chirayujain/SolarPoweredAQM/CAD/STLs/Battery Cover.stl

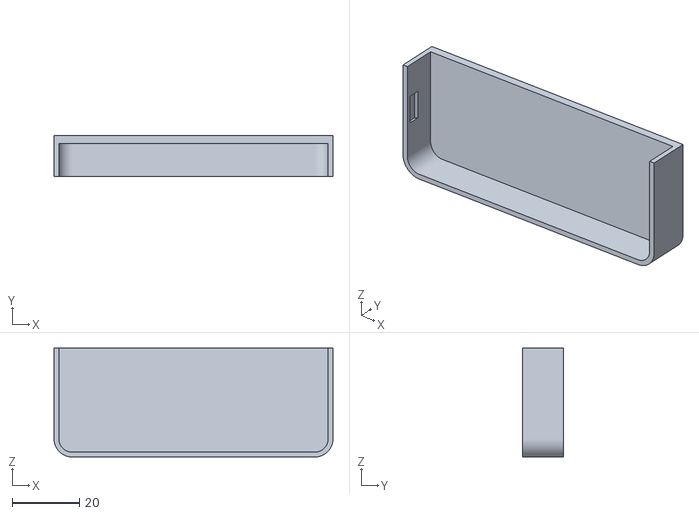
[picture p1: CAD file, 2025-01-18]
CAD/STLs/Battery Cover.stl
83.2 x 12.2 x 32.5
