chirayujain/SolarPoweredAQM/CAD/STLs/Enclosure Back.stl

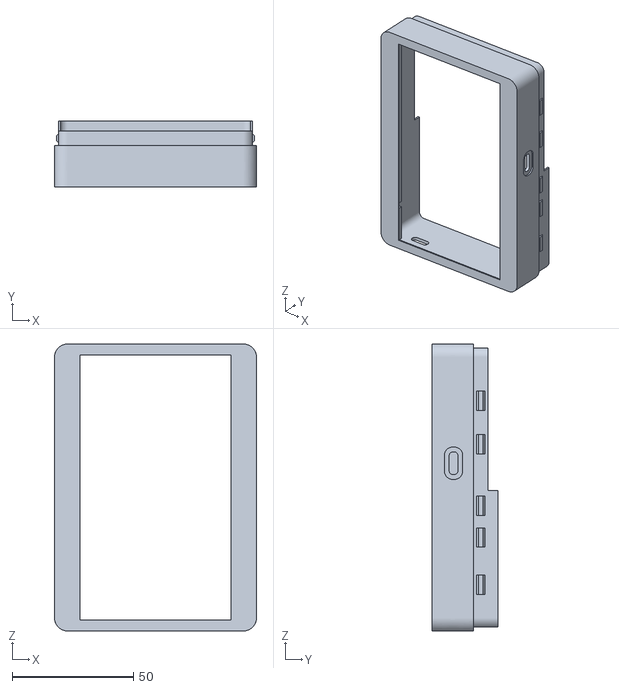
[picture p2: CAD file, 2025-01-18]
CAD/STLs/Enclosure Back.stl
83.2 x 27.0 x 118.2
