chirayujain/SolarPoweredAQM/CAD/STLs/Display Cover.stl

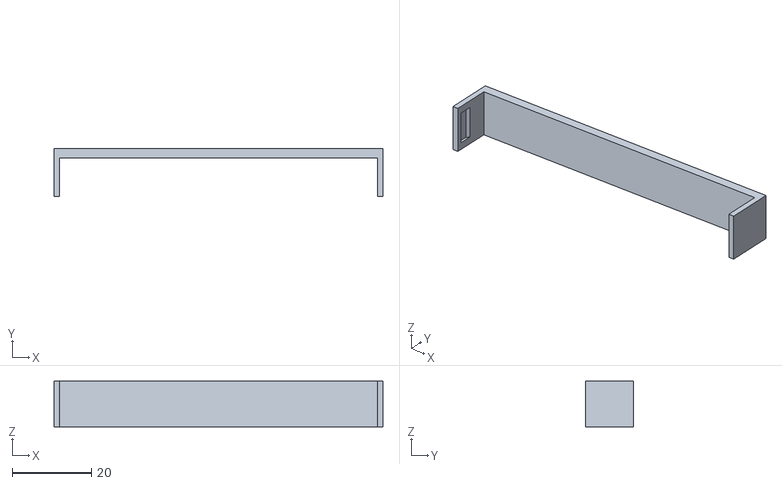
[picture p3: CAD file, 2025-01-18]
CAD/STLs/Display Cover.stl
83.2 x 12.2 x 11.6
