chirayujain/SolarPoweredAQM/CAD/STLs/Logo Panel.stl

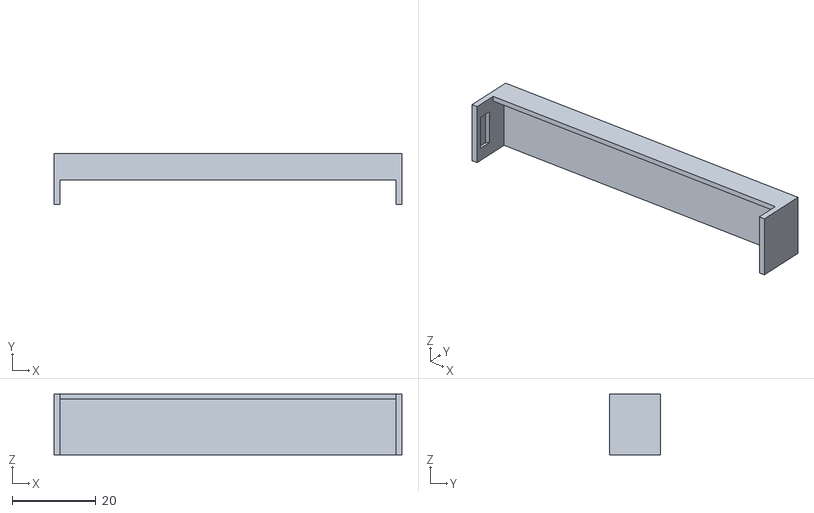
[picture p4: CAD file, 2025-01-18]
CAD/STLs/Logo Panel.stl
83.2 x 12.2 x 14.5
