chirayujain/SolarPoweredAQM/CAD/STLs/Vent.stl

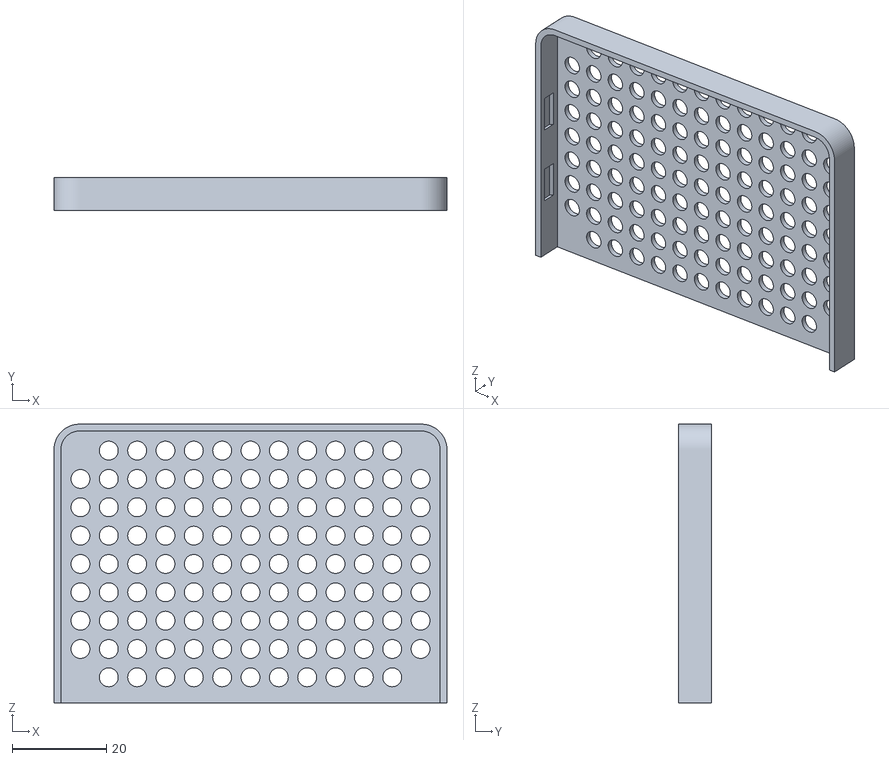
[picture p5: CAD file, 2025-01-18]
CAD/STLs/Vent.stl
83.2 x 7.05 x 59.0
