chirayujain/SolarPoweredAQM/CAD/STLs/LEDChannel.stl

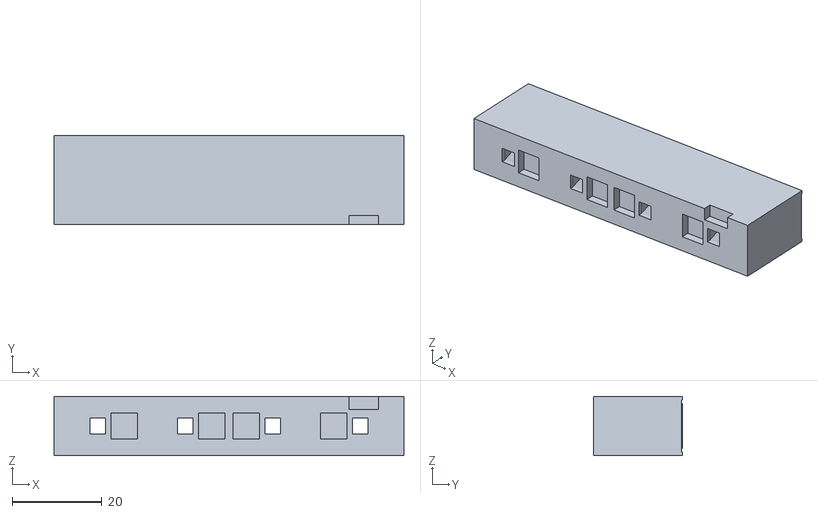
[picture p6: CAD file, 2025-01-18]
CAD/STLs/LEDChannel.stl
78.0 x 19.8 x 13.2
