chirayujain/SolarPoweredAQM/CAD/STLs/PMS Clip.stl

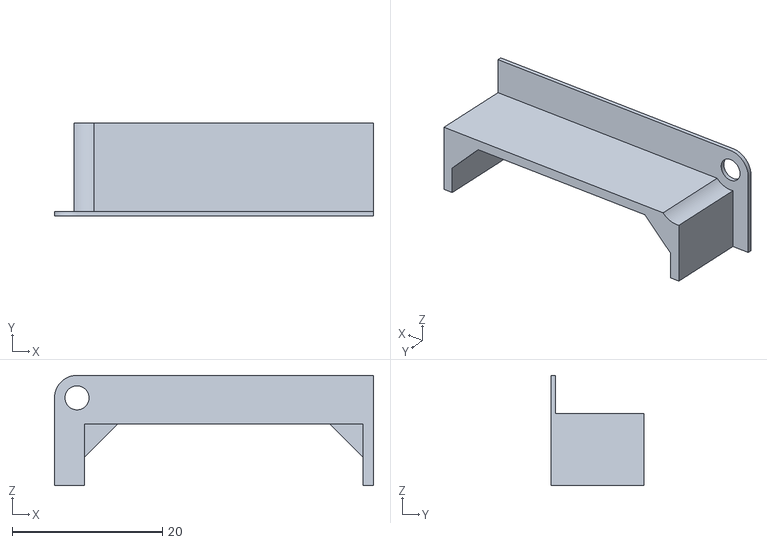
[picture p7: CAD file, 2025-01-18]
CAD/STLs/PMS Clip.stl
42.5 x 12.3 x 14.7
