chirayujain/SolarPoweredAQM/CAD/STLs/Wirechannel.stl

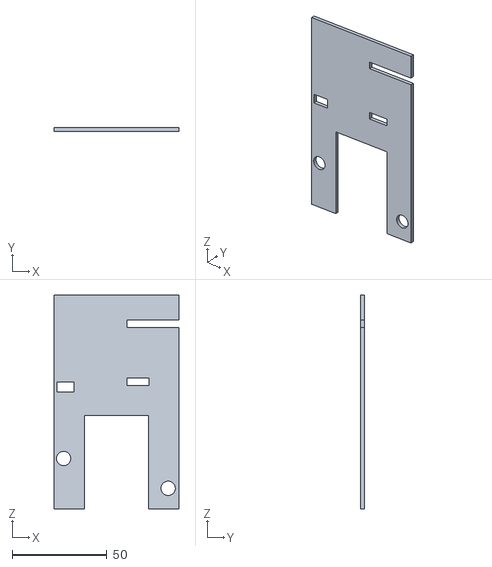
[picture p8: CAD file, 2025-01-18]
CAD/STLs/Wirechannel.stl
66.0 x 2.00 x 113.0
