chirayujain/SolarPoweredAQM/Electronics/Mainboard/AirQualityMonitorV1.kicad_pcb

## KiCad design Electronics/Mainboard/AirQualityMonitorV1.kicad_pcb (2025-01-18)

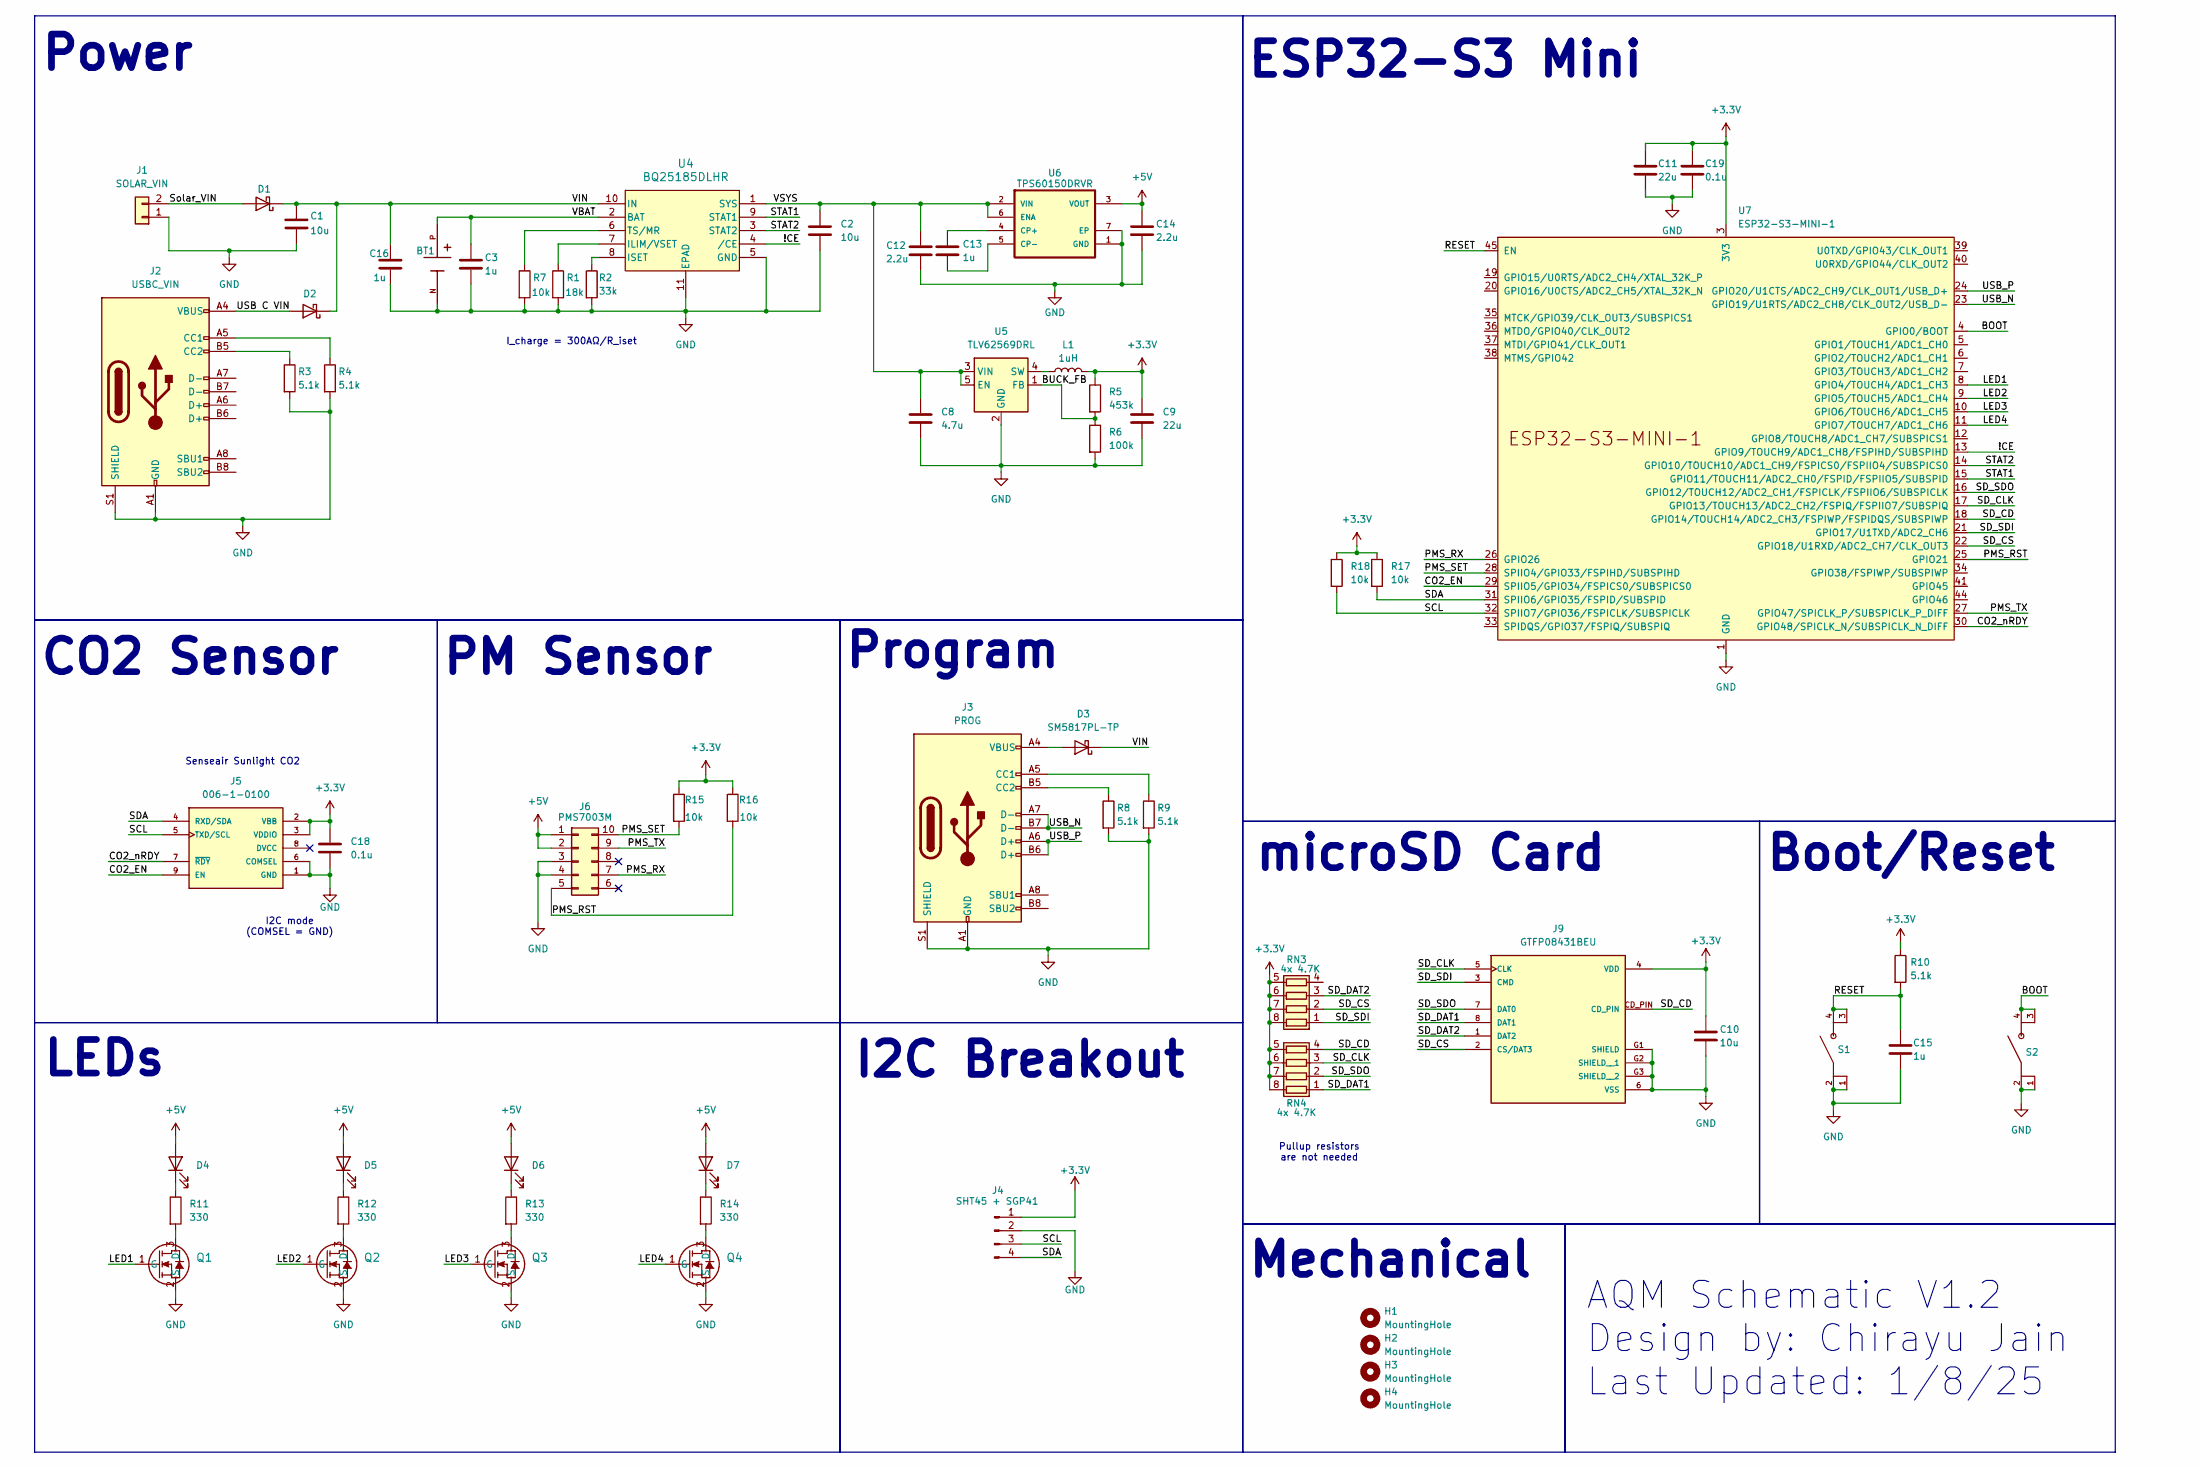
[picture p9: schematic AirQualityMonitorV1.kicad_sch]

Parts:
BT1: 1043; 1043_BAT_1043; PARTREV J
C1, C2, C10: 10u; C_0603_1608Metric
C3, C13, C15, C16: 1u; C_0603_1608Metric
C8: 4.7u; C_0603_1608Metric
C9, C11: 22u; C_0603_1608Metric
C12, C14: 2.2u; C_0603_1608Metric
C18, C19: 0.1u; C_0603_1608Metric
D1, D2, D3: SM5817PL-TP; D_SOD-123F
D4, D5, D6, D7: LED; LED_Luminus_MP-3030-1100_3.0x3.0mm
H1, H2, H3, H4: MountingHole; MountingHole_3.2mm_M3
J1: SOLAR_VIN; PinHeader_1x02_P2.54mm_Vertical
J2: USBC_VIN; USB_C_Receptacle_GCT_USB4105-xx-A_16P_TopMnt_Horizontal
J3: PROG; USB_C_Receptacle_GCT_USB4105-xx-A_16P_TopMnt_Horizontal
J4: SHT45 + SGP41; PinHeader_1x04_P2.54mm_Vertical
J5: 006-1-0100; 006-0-0002_XDCR_006-0-0002; PARTREV 1.00.000
J6: PMS7003M; PinSocket_2x05_P1.27mm_Vertical
J9: GTFP08431BEU; GTFP08431BEU_AMPHENOL_GTFP08431BEU; PARTREV F
L1: 1uH; L_Coilcraft_XxL4020
Q1, Q2, Q3, Q4: AO3422; SOT23_AOS
R1: 18k; R_0603_1608Metric
R2: 33k; R_0603_1608Metric
R3, R4, R8, R9, R10: 5.1k; R_0603_1608Metric
R5: 453k; R_0603_1608Metric
R6: 100k; R_0603_1608Metric
R7, R15, R16, R17, R18: 10k; R_0603_1608Metric
R11, R12, R13, R14: 330; R_0603_1608Metric
RN3, RN4: 4x 4.7K; R_Array_Convex_4x1206
S1, S2: PTS815_SJG
U4: BQ25185DLHR; WSON10_DLH_TEX
U5: TLV62569DRL; SOT-563
U6: TPS60150DRVR; TPS60150DRVR_SON65P200X200X80-7N
U7: ESP32-S3-MINI-1

Connections:
+3.3V: C9.1, C10.1, C11.1, C18.1, C19.1, J4.1, J5.2 (VBB), J5.3 (VDDIO), J9.4 (VDD), L1.2, R5.1, R10.1, R15.1, R16.1, R17.1, R18.1, RN3.5 (R4.2), RN3.6 (R3.2), RN3.7 (R2.2), RN3.8 (R1.2), RN4.5 (R4.2), RN4.6 (R3.2), RN4.7 (R2.2), RN4.8 (R1.2), U7.3 (3V3)
+5V: C14.1, D4.2 (A), D5.2 (A), D6.2 (A), D7.2 (A), J6.1, J6.2, U6.3 (VOUT)
/!CE: U4.4 (/CE), U7.13 (GPIO9/TOUCH9/ADC1_CH8/FSPIHD/SUBSPIHD)
/BOOT: S2.3, S2.4, U7.4 (GPIO0/BOOT)
/BUCK_FB: R5.2, R6.1, U5.1 (FB)
/CO2_EN: J5.9 (EN), U7.29 (SPIIO5/GPIO34/FSPICS0/SUBSPICS0)
/CO2_nRDY: J5.7 (~RDY), U7.30 (GPIO48/SPICLK_N/SUBSPICLK_N_DIFF)
/LED1: Q1.1 (G), U7.8 (GPIO4/TOUCH4/ADC1_CH3)
/LED2: Q2.1 (G), U7.9 (GPIO5/TOUCH5/ADC1_CH4)
/LED3: Q3.1 (G), U7.10 (GPIO6/TOUCH6/ADC1_CH5)
/LED4: Q4.1 (G), U7.11 (GPIO7/TOUCH7/ADC1_CH6)
/PMS_RST: J6.5, R16.2, U7.25 (GPIO21)
/PMS_RX: J6.7, U7.26 (GPIO26)
/PMS_SET: J6.10, R15.2, U7.28 (SPIIO4/GPIO33/FSPIHD/SUBSPIHD)
/PMS_TX: J6.9, U7.27 (GPIO47/SPICLK_P/SUBSPICLK_P_DIFF)
/RESET: C15.1, R10.2, S1.3, S1.4, U7.45 (EN)
/SCL: J4.3, J5.5 (TXD/SCL), R18.2, U7.32 (SPIIO7/GPIO36/FSPICLK/SUBSPICLK)
/SDA: J4.4, J5.4 (RXD/SDA), R17.2, U7.31 (SPIIO6/GPIO35/FSPID/SUBSPID)
/SD_CD: J9.CD_PIN, RN4.4 (R4.1), U7.18 (GPIO14/TOUCH14/ADC2_CH3/FSPIWP/FSPIDQS/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)
/SD_CLK: J9.5 (CLK), RN4.3 (R3.1), U7.17 (GPIO13/TOUCH13/ADC2_CH2/FSPIQ/FSPIIO7/S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)
/SD_CS: J9.2 (CS/DAT3), RN3.2 (R2.1), U7.22 (GPIO18/U1RXD/ADC2_CH7/CLK_OUT3)
/SD_DAT1: J9.8 (DAT1), RN4.1 (R1.1)
/SD_DAT2: J9.1 (DAT2), RN3.3 (R3.1)
/SD_SDI: J9.3 (CMD), RN3.1 (R1.1), U7.21 (GPIO17/U1TXD/ADC2_CH6)
/SD_SDO: J9.7 (DAT0), RN4.2 (R2.1), U7.16 (GPIO12/TOUCH12/ADC2_CH1/FSPICLK/FSPIIO6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)
/STAT1: U4.9 (STAT1), U7.15 (GPIO11/TOUCH11/ADC2_CH0/FSPID/FSPIIO5/S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)
/STAT2: U4.3 (STAT2), U7.14 (GPIO10/TOUCH10/ADC1_CH9/FSPICS0/FSPIIO4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)
/Solar_VIN: D1.2 (A), J1.2
/USB C VIN: D2.2 (A), J2.A4 (VBUS), J2.A9 (VBUS), J2.B4 (VBUS), J2.B9 (VBUS)
/USB_N: J3.A7 (D-), J3.B7 (D-), U7.23 (GPIO19/U1RTS/ADC2_CH8/CLK_OUT2/USB_D-)
/USB_P: J3.A6 (D+), J3.B6 (D+), U7.24 (GPIO20/U1CTS/ADC2_CH9/CLK_OUT1/USB_D+)
/VBAT: BT1.P, C3.1, U4.2 (BAT)
/VIN: C1.1, C16.1, D1.1 (K), D2.1 (K), D3.1 (K), U4.10 (IN)
/VSYS: C2.1, C8.1, C12.1, U4.1 (SYS), U5.3 (VIN), U5.5 (EN), U6.2 (VIN), U6.6 (ENA)
GND: BT1.N, C1.2, C2.2, C3.2, C8.2, C9.2, C10.2, C11.2, C12.2, C14.2, C15.2, C16.2, C18.2, C19.2, J1.1, J2.A1 (GND), J2.A12 (GND), J2.B1 (GND), J2.B12 (GND), J2.S1 (SHIELD), J3.A1 (GND), J3.A12 (GND), J3.B1 (GND), J3.B12 (GND), J3.S1 (SHIELD), J4.2, J5.1 (GND), J5.6 (COMSEL), J6.3, J6.4, J9.6 (VSS), J9.G1 (SHIELD), J9.G2 (SHIELD__1), J9.G3 (SHIELD__2), Q1.2 (S), Q2.2 (S), Q3.2 (S), Q4.2 (S), R1.2, R2.2, R3.2, R4.2, R6.2, R7.2, R8.2, R9.2, S1.1, S1.2, S2.1, S2.2, U4.5 (GND), U4.11 (EPAD), U5.2 (GND), U6.1 (GND), U6.7 (EP), U7.1 (GND), U7.2 (GND), U7.42 (GND), U7.43 (GND), U7.46 (GND), U7.47 (GND), U7.48 (GND), U7.49 (GND), U7.50 (GND), U7.51 (GND), U7.52 (GND), U7.53 (GND), U7.54 (GND), U7.55 (GND), U7.56 (GND), U7.57 (GND), U7.58 (GND), U7.59 (GND), U7.60 (GND), U7.61 (GND), U7.62 (GND), U7.63 (GND), U7.64 (GND), U7.65 (GND)
unnamed: D3.2 (A), J3.A4 (VBUS), J3.A9 (VBUS), J3.B4 (VBUS), J3.B9 (VBUS)
unnamed: D4.1 (K), R11.1
unnamed: D5.1 (K), R12.1
unnamed: D6.1 (K), R13.1
unnamed: D7.1 (K), R14.1
unnamed: J2.A5 (CC1), R4.1
unnamed: J2.B5 (CC2), R3.1
unnamed: J3.A5 (CC1), R9.1
unnamed: J3.B5 (CC2), R8.1
unnamed: Q1.3 (D), R11.2
unnamed: Q2.3 (D), R12.2
unnamed: Q3.3 (D), R13.2
unnamed: Q4.3 (D), R14.2
unnamed: R1.1, U4.7 (ILIM/VSET)
unnamed: R2.1, U4.8 (ISET)
unnamed: R7.1, U4.6 (TS/MR)
unnamed: L1.1, U5.4 (SW)
unnamed: C13.1, U6.4 (CP+)
unnamed: C13.2, U6.5 (CP-)

Notes on the sheet:
AQM Schematic V1.2 Design by: Chirayu Jain Last Updated: 1/8/25
microSD Card
CO2 Sensor
Senseair Sunlight CO2
ESP32-S3 Mini
Power
LEDs
PM Sensor
I2C Breakout
Mechanical
Boot/Reset
Pullup resistors are not needed
I_charge = 300AΩ/R_iset
I2C mode (COMSEL = GND)
Program

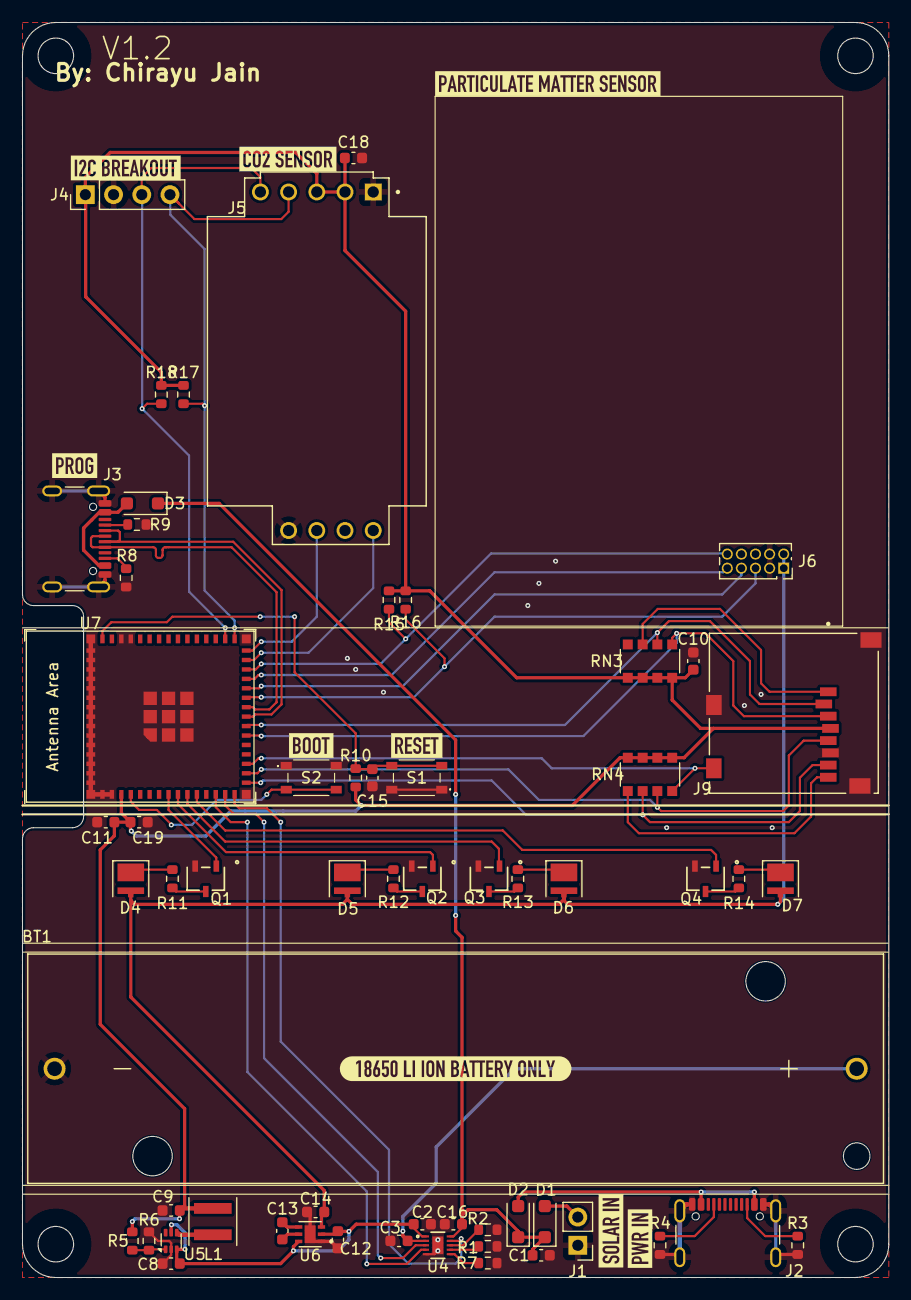
[picture p10: board AirQualityMonitorV1.kicad_pcb from above]

Board: 2 copper layers, 78.0 x 113.0 mm, 73 parts (0 on the bottom side), 54 nets.

Other parts of the board:
kibuzzard-66CA2A9F: G***; kibuzzard-66CA2A9F
kibuzzard-66CA2A40: G***; kibuzzard-66CA2A40
kibuzzard-66CA2A73: G***; kibuzzard-66CA2A73
kibuzzard-66CA2ABD: G***; kibuzzard-66CA2ABD
kibuzzard-66CA2AE0: G***; kibuzzard-66CA2AE0
kibuzzard-66CA2B1F: G***; kibuzzard-66CA2B1F
kibuzzard-66CA2B19: G***; kibuzzard-66CA2B19
kibuzzard-66CA2899: G***; kibuzzard-66CA2899
kibuzzard-66CB4D05: G***; kibuzzard-66CB4D05
