chirayujain/SolarPoweredAQM/Electronics/SHT4x_SGP41_Breakout/SHT4x_SGP41_Breakout.kicad_pcb

## KiCad design Electronics/SHT4x_SGP41_Breakout/SHT4x_SGP41_Breakout.kicad_pcb (2025-01-18)

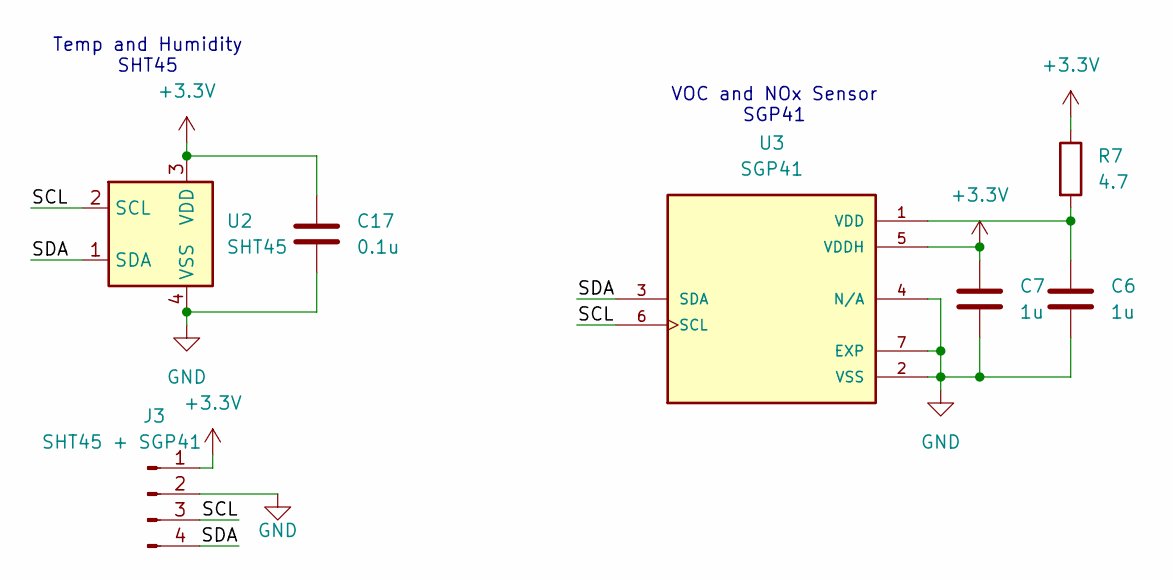
[picture p11: schematic SHT4x_SGP41_Breakout.kicad_sch]

Parts:
C6, C7: 1u; C_0603_1608Metric
C17: 0.1u; C_0603_1608Metric
J3: SHT45 + SGP41; PinHeader_1x04_P2.54mm_Vertical
R7: 4.7; R_0603_1608Metric
U2: SHT45; Sensirion_DFN-4_1.5x1.5mm_P0.8mm_SHT4x_NoCentralPad
U3: SGP41; SGP41-D-R4_XDCR_SGP41-D-R4; PARTREV 1.0

Connections:
+3.3V: C7.1, C17.1, J3.1, R7.1, U2.3 (VDD), U3.5 (VDDH)
/SCL: J3.3, U2.2 (SCL), U3.6 (SCL)
/SDA: J3.4, U2.1 (SDA), U3.3 (SDA)
GND: C6.2, C7.2, C17.2, J3.2, U2.4 (VSS), U3.2 (VSS), U3.4 (N/A), U3.7 (EXP)
unnamed: C6.1, R7.2, U3.1 (VDD)

Notes on the sheet:
Temp and Humidity SHT45
VOC and NOx Sensor SGP41

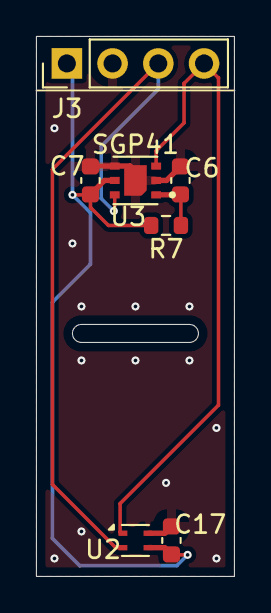
[picture p12: board SHT4x_SGP41_Breakout.kicad_pcb from above]

Board: 2 copper layers, 11.0 x 30.0 mm, 7 parts (0 on the bottom side), 5 nets.
